rocob/ATmegaProg/images/ATmegaProg_back2.png

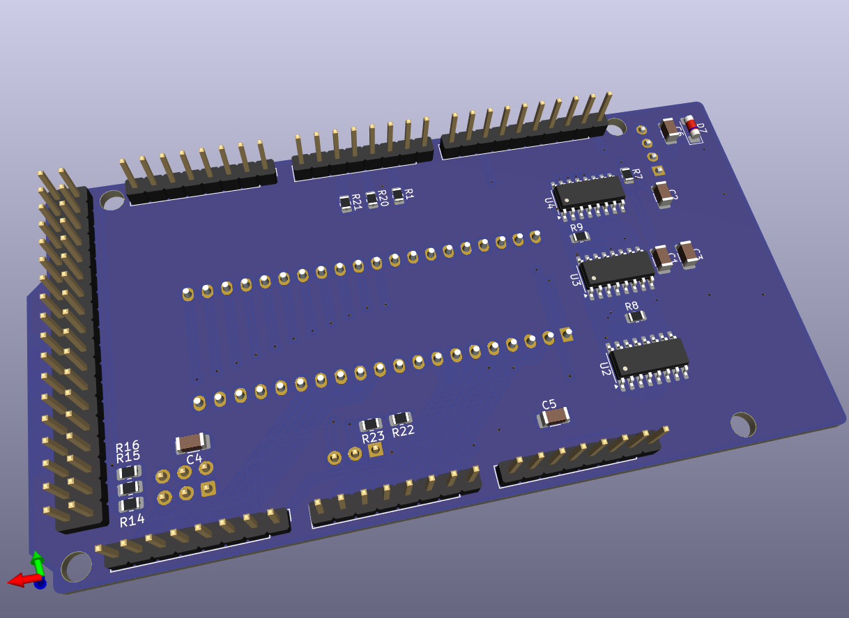
images/ATmegaProg_back2.png
