rocob/ATmegaProg/images/ATmegaProg_back.png

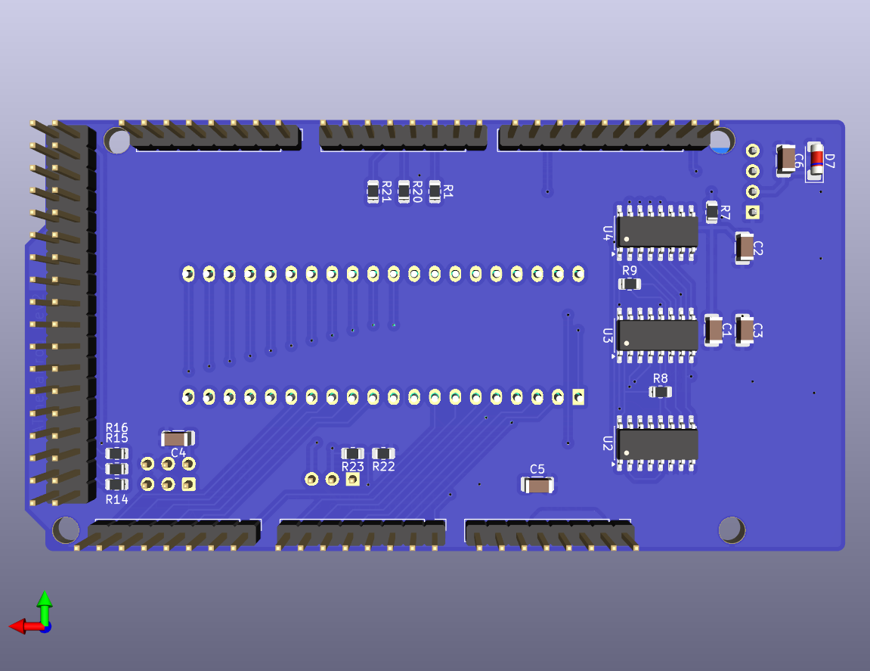
images/ATmegaProg_back.png
