rocob/ATmegaProg/images/ATmegaProg_front2.png

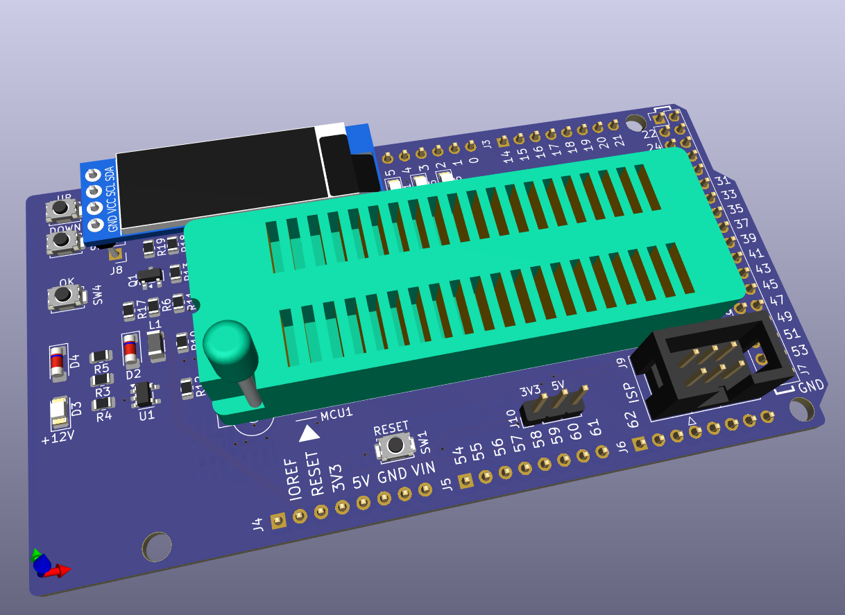
images/ATmegaProg_front2.png
