rocob/ATmegaProg/images/ATmegaProg_front.png

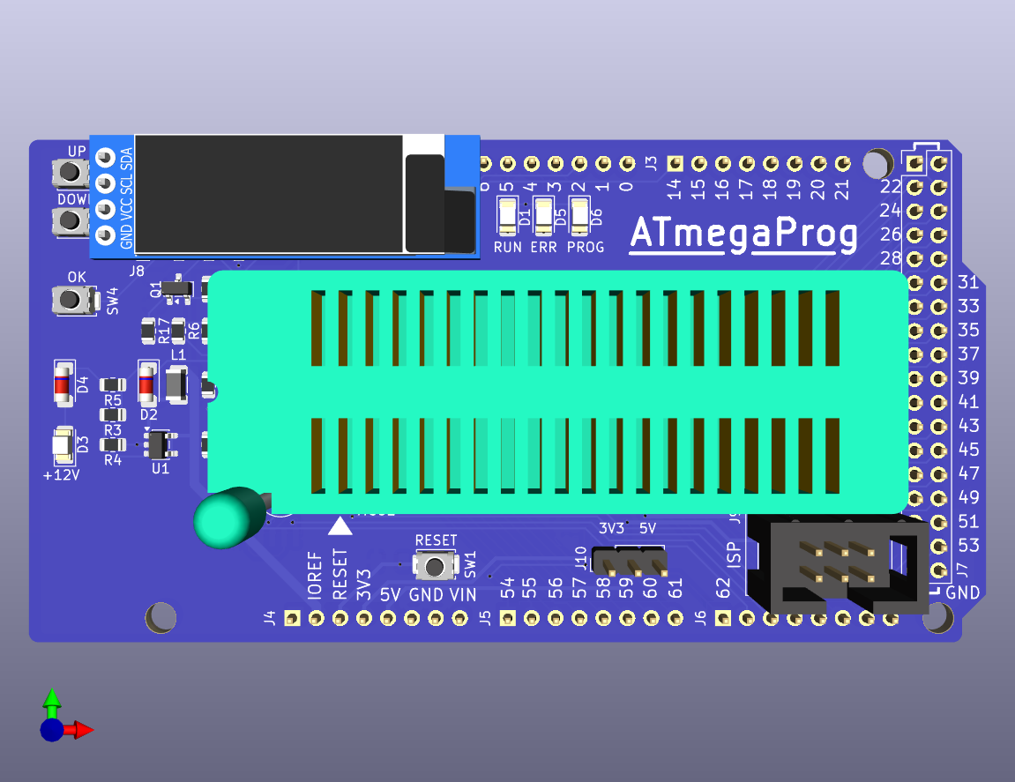
images/ATmegaProg_front.png
