rocob/ATmegaProg/src/changelog.md

1.1.0
- remap pins for ZIF40
- remap pin RESET for IDC06
- remap pin Key_OK
- new version of schematics and board Rev2

1.0.3  
- display migrate from Adafruit to u8g2 book

1.0.2  12.04.2026
- add more signatures
- add IDC06 VTARGET Voltage Sense
- add HV 12V Currency Sense

1.0.1  04.04.2026
- function lcdPrintHex() changed
- add STKError variable results to stk500v2.h
- add pooling RDY/BSY to CMD_ENTER_PROGMODE_ISP, CMD_CHIP_ERASE_ISP,
    CMD_PROGRAM_FLASH_ISP, CMD_PROGRAM_EEPROM_ISP, 

1.0.0  03.04.2026
- initial worked version
