rocob/ATmegaProg/images/ATmegaProg_sch.pdf

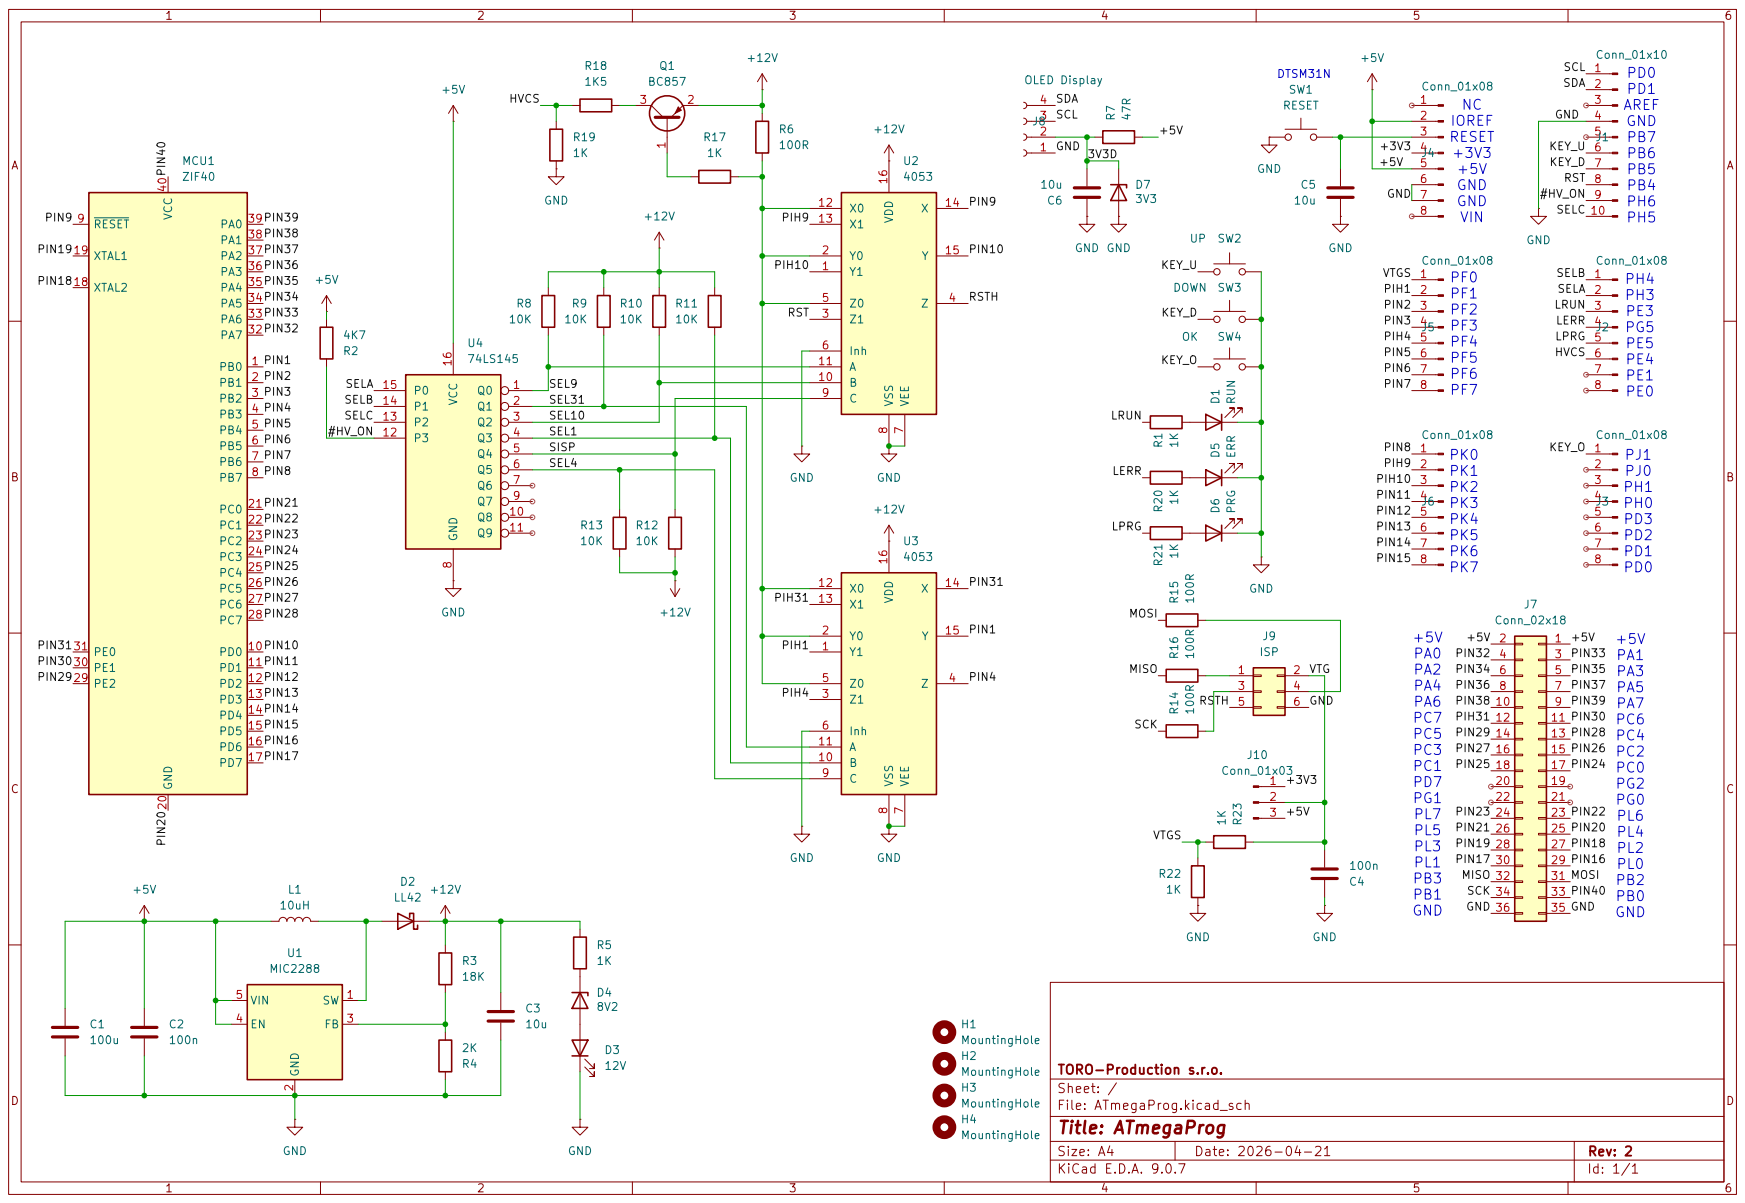
[picture p6: page 1]
